climbalima/let-s-Split-v2/lets_split/lets_split.kicad_pcb

## KiCad design lets_split/lets_split.kicad_pcb (2017-04-17)

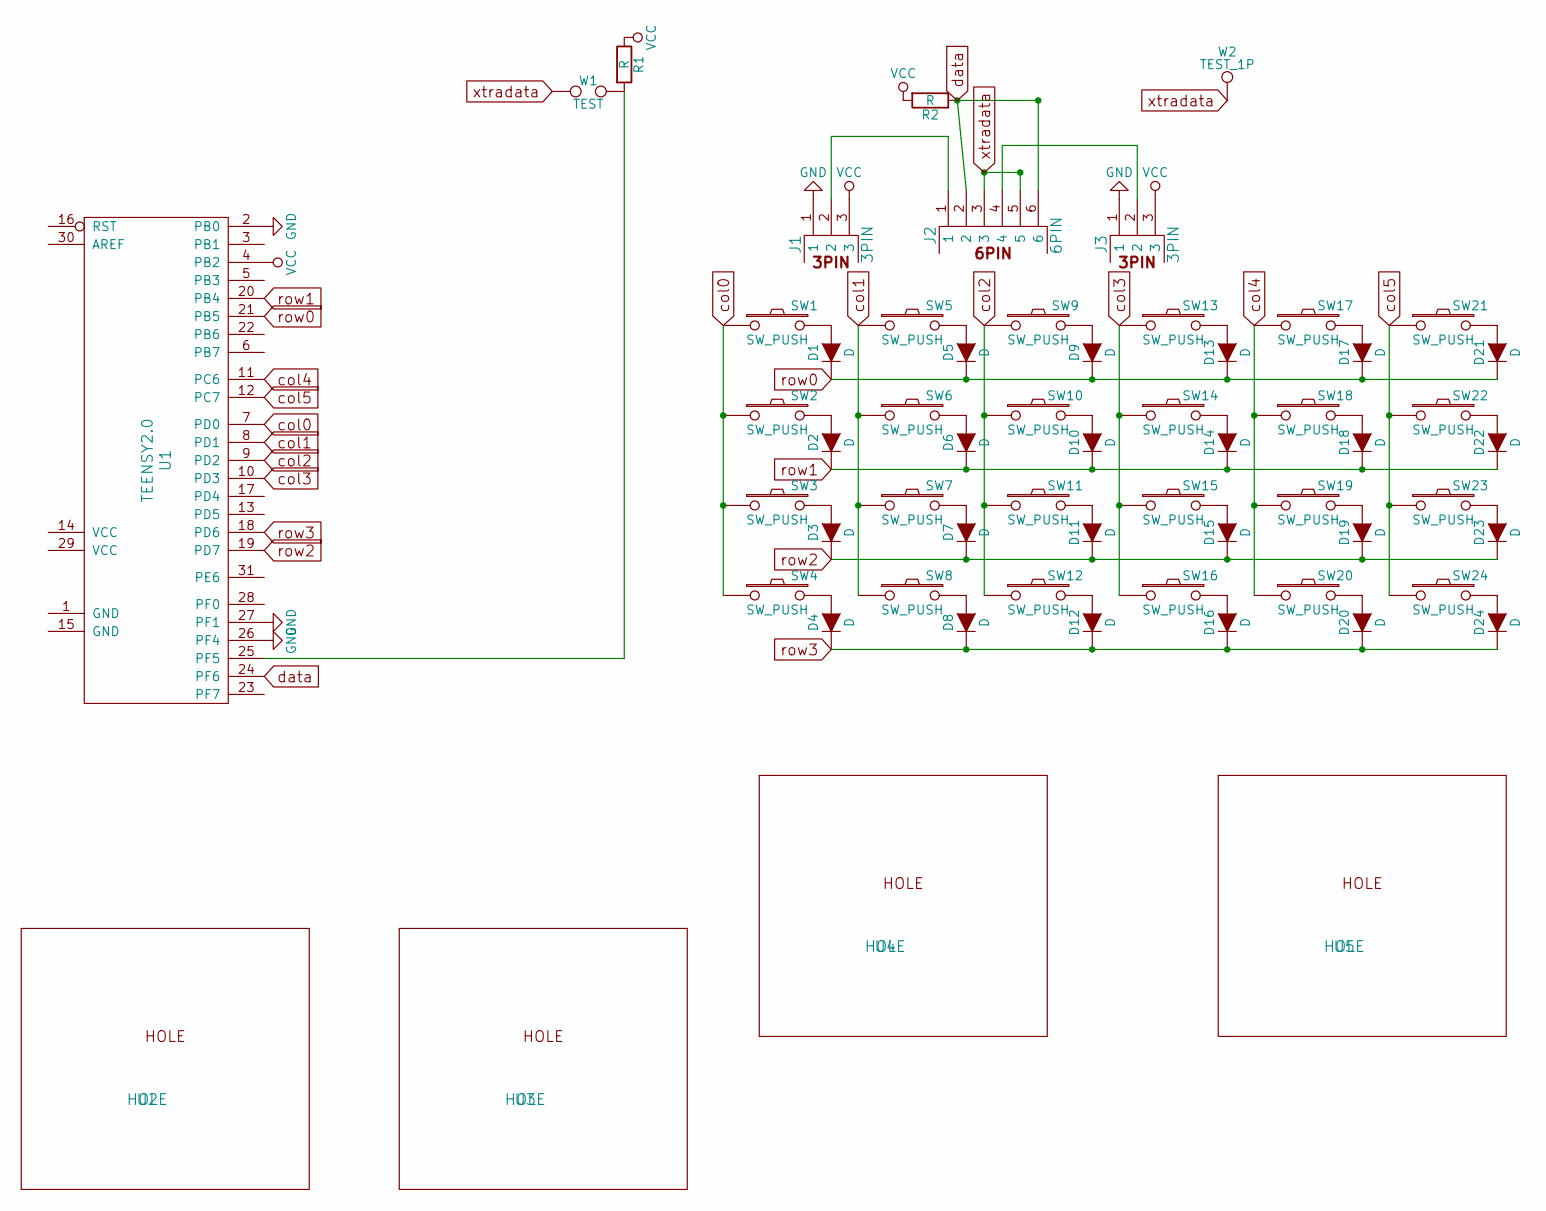
[picture p1: schematic lets_split.sch]

Parts:
D1, D2, D3, D4, D5, D6, D7, D8, D9, D10, D11, D12, D13, D14, D15, D16, D17, D18, D19, D20, D21, D22, D23, D24: D; Diode_DO-41_SOD81_Horizontal_RM10
J1, J3: 3PIN; jumper
J2: 6PIN; 4pin35mmAudio
R1, R2: R; RESISTOR
SW1, SW2, SW3, SW4, SW5, SW6, SW7, SW8, SW9, SW10, SW11, SW12, SW13, SW14, SW15, SW16, SW17, SW18, SW19, SW20, SW21, SW22, SW23, SW24: SW_PUSH; MXALPS_FLIP
U1: TEENSY2.0; TEENSY_2.0
U2, U3, U4, U5: HOLE
W1: TEST; JUMPER_SMD_2DUB
W2: TEST_1P; SolderWirePad_single_2mmDrill

Connections:
GND: J1.1, J3.1, U1.2 (PB0), U1.26 (PF4), U1.27 (PF1)
unnamed: D1.2 (A), SW1.2
unnamed: D2.2 (A), SW2.2
unnamed: D3.2 (A), SW3.2
unnamed: D4.2 (A), SW4.2
unnamed: D5.2 (A), SW5.2
unnamed: D6.2 (A), SW6.2
unnamed: D7.2 (A), SW7.2
unnamed: D8.2 (A), SW8.2
unnamed: D9.2 (A), SW9.2
unnamed: D10.2 (A), SW10.2
unnamed: D11.2 (A), SW11.2
unnamed: D12.2 (A), SW12.2
unnamed: D13.2 (A), SW13.2
unnamed: D14.2 (A), SW14.2
unnamed: D15.2 (A), SW15.2
unnamed: D16.2 (A), SW16.2
unnamed: D17.2 (A), SW17.2
unnamed: D18.2 (A), SW18.2
unnamed: D19.2 (A), SW19.2
unnamed: D20.2 (A), SW20.2
unnamed: D21.2 (A), SW21.2
unnamed: D22.2 (A), SW22.2
unnamed: D23.2 (A), SW23.2
unnamed: D24.2 (A), SW24.2
unnamed: J1.2, J2.1
unnamed: J2.4, J3.2
unnamed: R1.2, U1.25 (PF5), W1.2
VCC: J1.3, J3.3, R1.1, R2.2, U1.4 (PB2)
col0: SW1.1, SW2.1, SW3.1, SW4.1, U1.7 (PD0)
col1: SW5.1, SW6.1, SW7.1, SW8.1, U1.8 (PD1)
col2: SW9.1, SW10.1, SW11.1, SW12.1, U1.9 (PD2)
col3: SW13.1, SW14.1, SW15.1, SW16.1, U1.10 (PD3)
col4: SW17.1, SW18.1, SW19.1, SW20.1, U1.11 (PC6)
col5: SW21.1, SW22.1, SW23.1, SW24.1, U1.12 (PC7)
data: J2.2, J2.6, R2.1, U1.24 (PF6)
row0: D1.1 (K), D5.1 (K), D9.1 (K), D13.1 (K), D17.1 (K), D21.1 (K), U1.21 (PB5)
row1: D2.1 (K), D6.1 (K), D10.1 (K), D14.1 (K), D18.1 (K), D22.1 (K), U1.20 (PB4)
row2: D3.1 (K), D7.1 (K), D11.1 (K), D15.1 (K), D19.1 (K), D23.1 (K), U1.19 (PD7)
row3: D4.1 (K), D8.1 (K), D12.1 (K), D16.1 (K), D20.1 (K), D24.1 (K), U1.18 (PD6)
xtradata: J2.3, J2.5, W1.1, W2.1

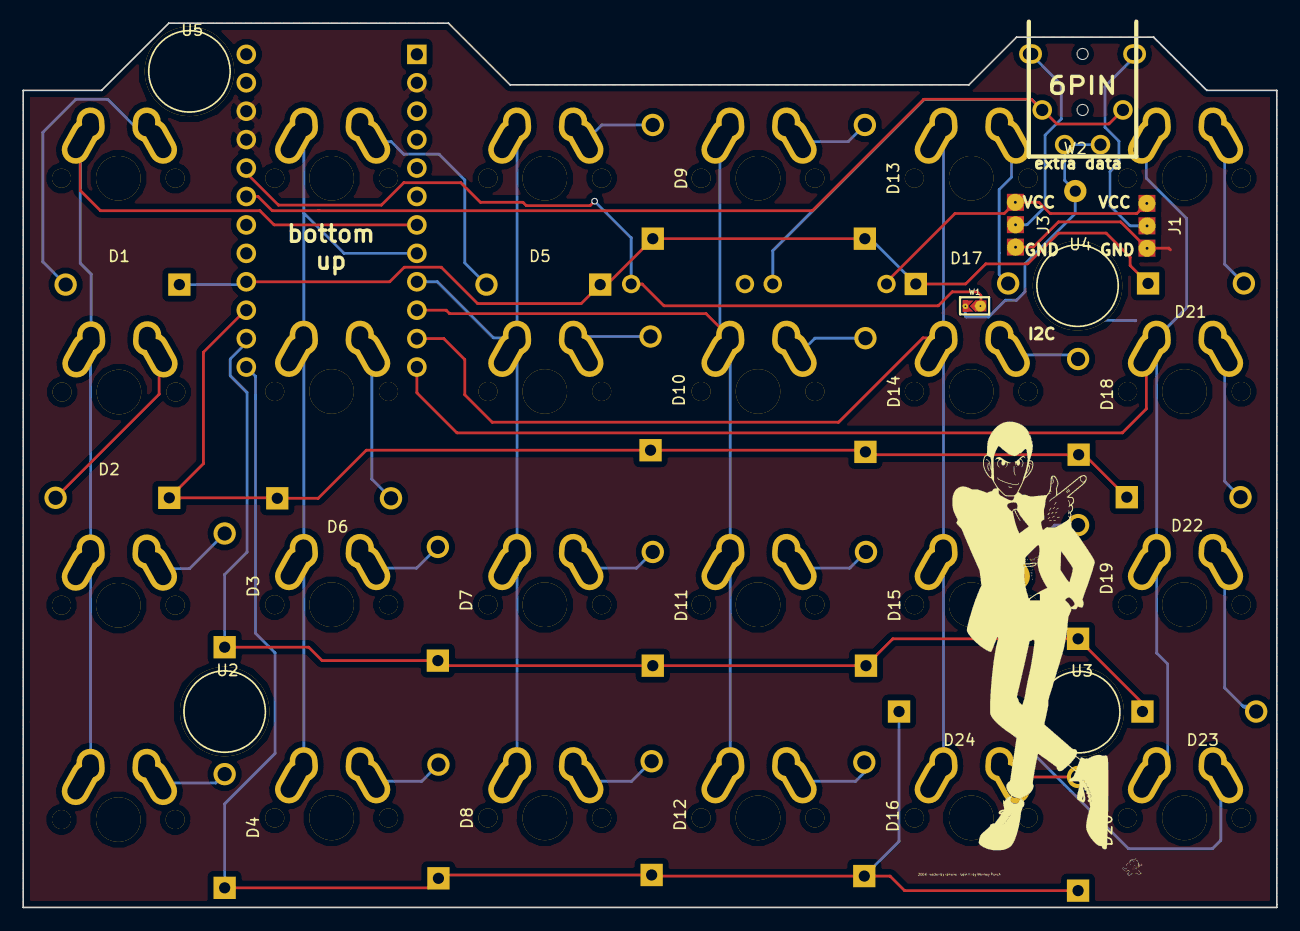
[picture p2: board lets_split.kicad_pcb from above]

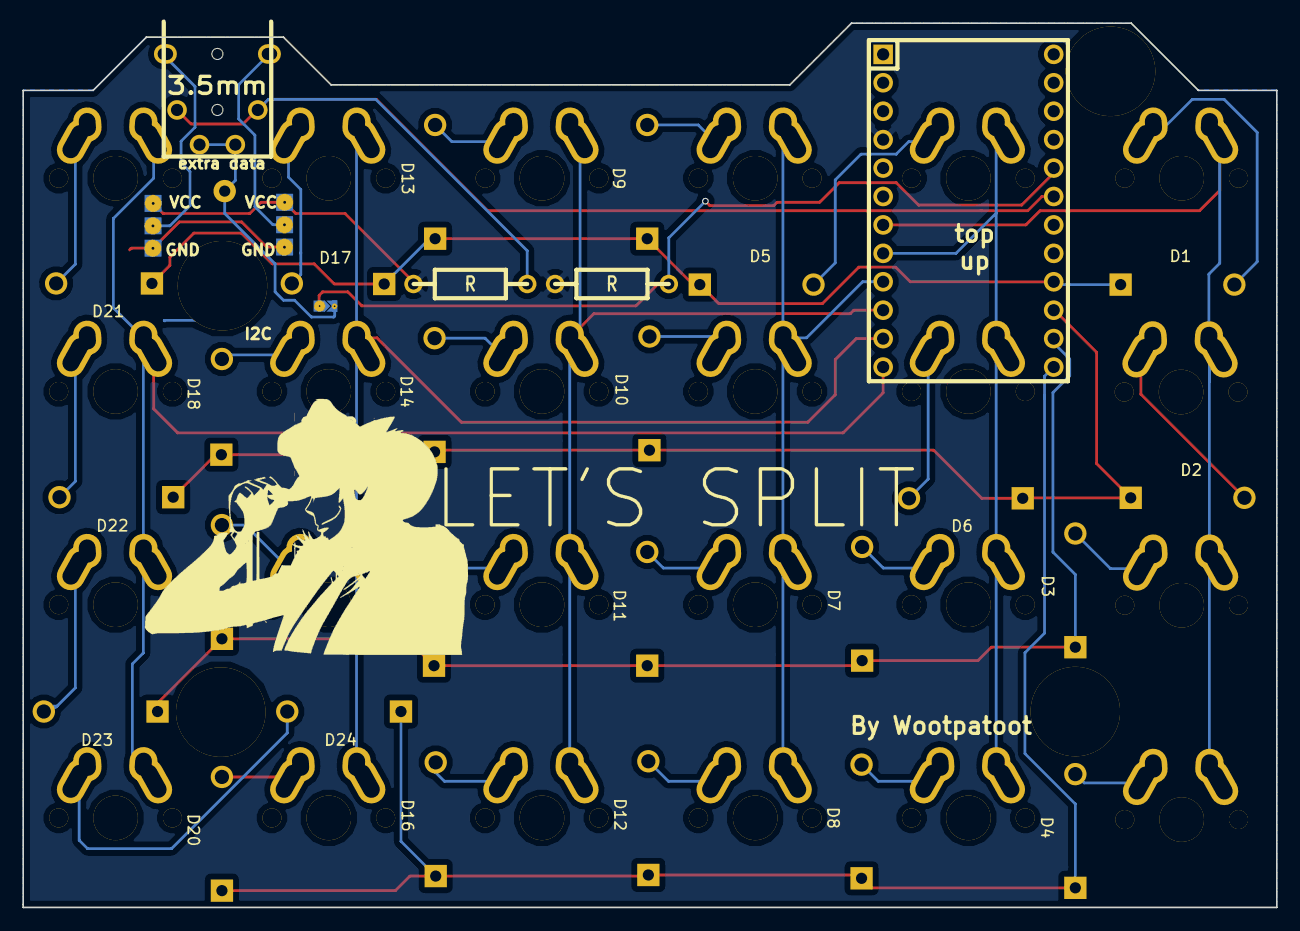
[picture p3: board lets_split.kicad_pcb from below]

Board: 2 copper layers, 112.0 x 79.0 mm, 58 parts (3 on the bottom side), 39 nets.
